boriz/CentronicsArduino/Images/SA003.PNG

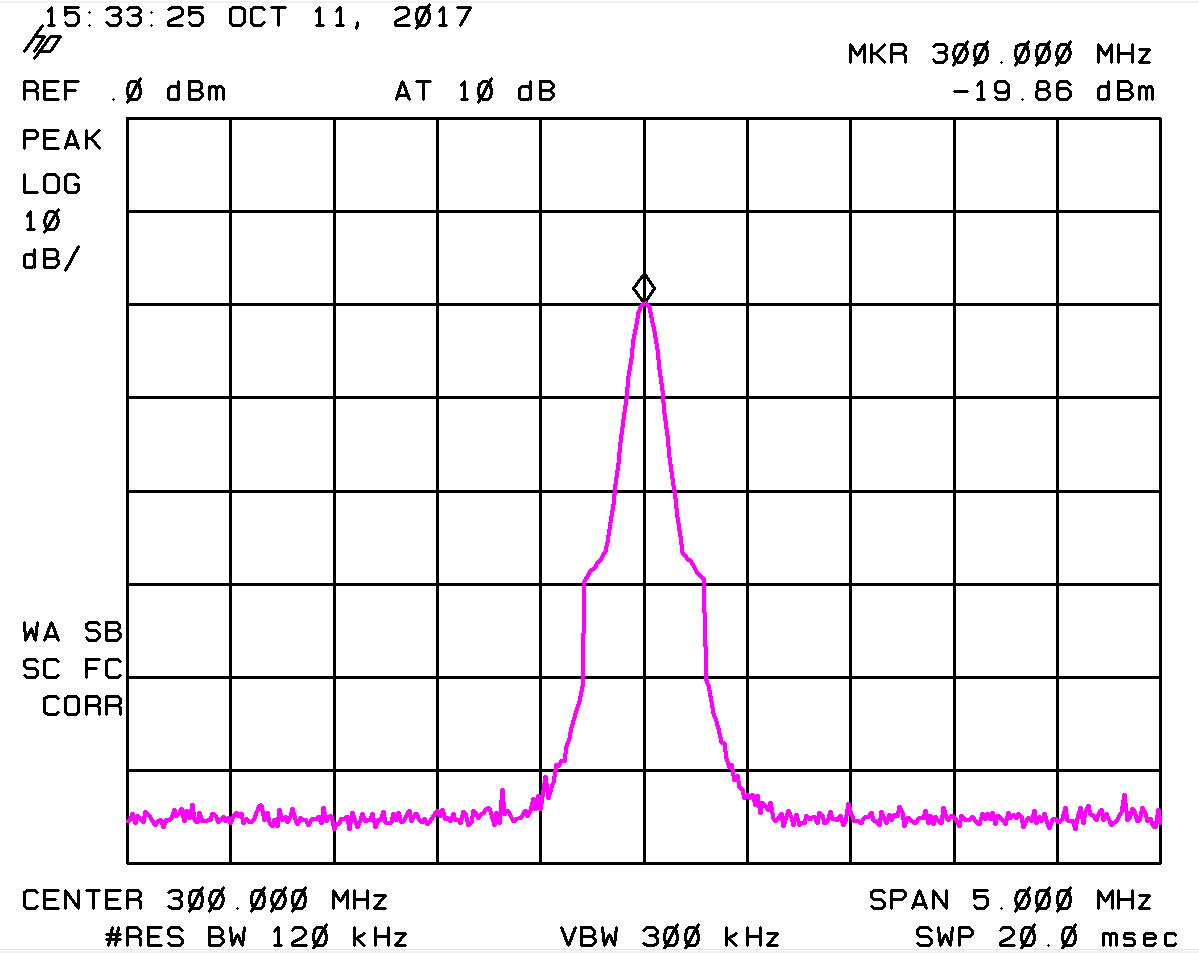
Images/SA003.PNG
