boriz/CentronicsArduino/(threads)

Thread 1 (2018-09-07):

centronics to pin wiring diagram

FredBesterwitch, 2018-09-07:
Hi do you have a any drawing or diagram how to connect centronics to the arduino pins, do the centroinc voltage 5v to 3.3 matter ?

boriz, 2018-11-24:
Centronics interface is 5V.
I added a table to the readme file with arduino to Centronics pinout.
